apolinarykalemba/Pico-Cyberdeck/picture/IMG_20261005_202635_535.jpg

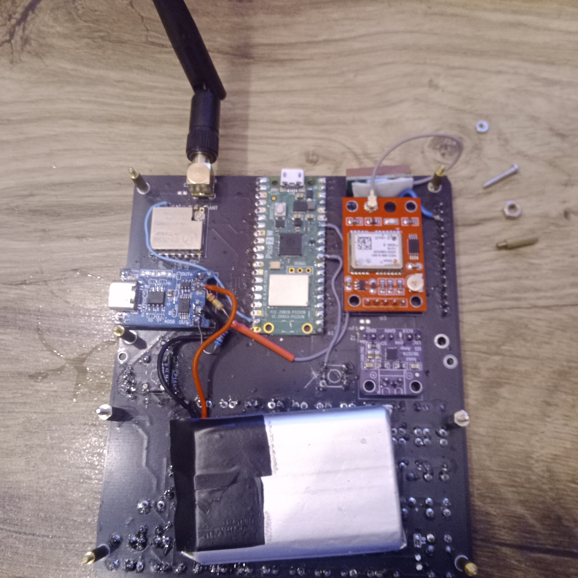
picture/IMG_20261005_202635_535.jpg
