apolinarykalemba/Pico-Cyberdeck/picture/IMG_20261005_202928_706.jpg

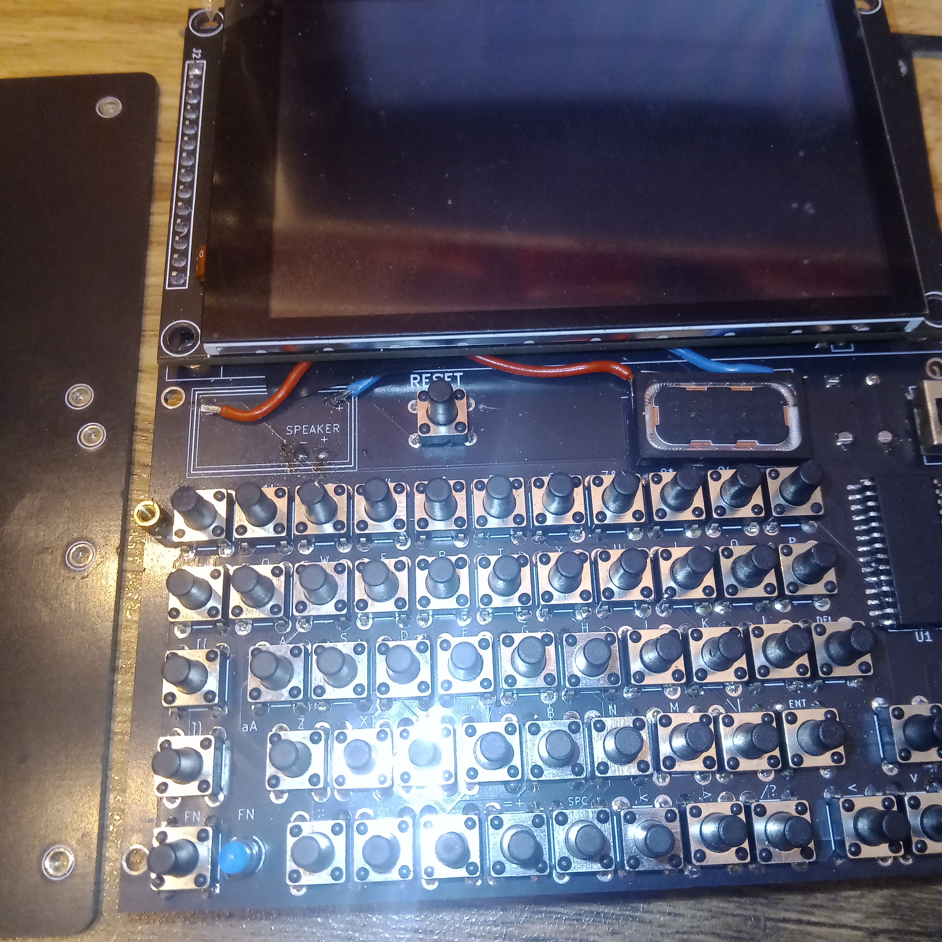
picture/IMG_20261005_202928_706.jpg
