apolinarykalemba/Pico-Cyberdeck/picture/IMG_20261005_202944_932.jpg

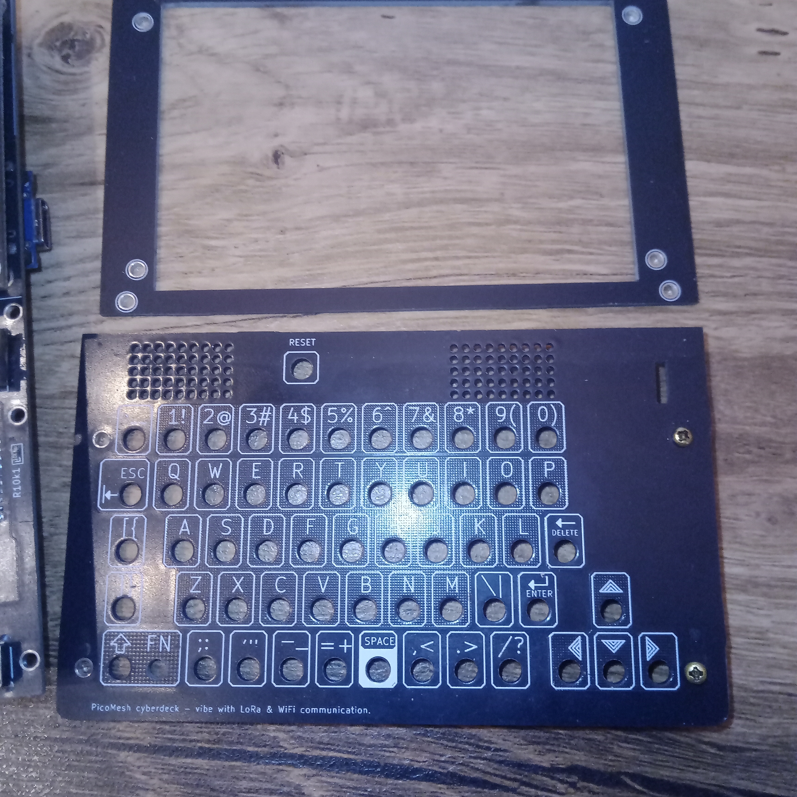
picture/IMG_20261005_202944_932.jpg
