apolinarykalemba/Pico-Cyberdeck/picture/IMG_20261005_202951_774.jpg

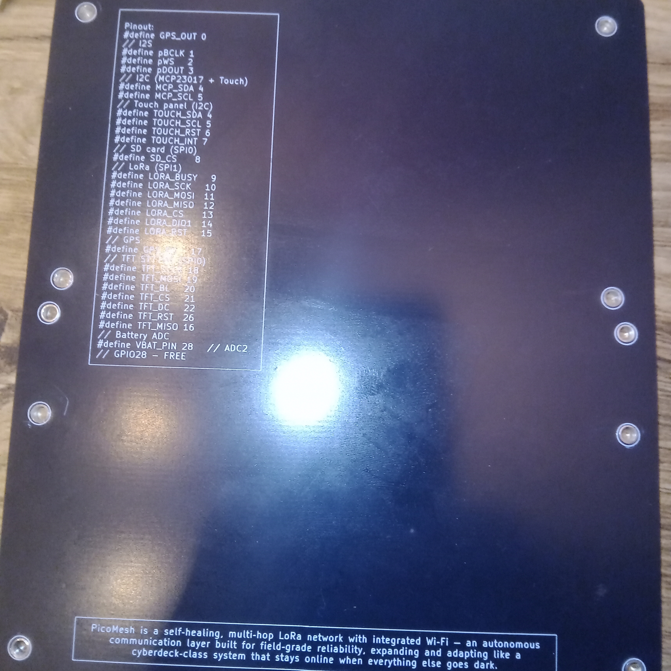
picture/IMG_20261005_202951_774.jpg
