apolinarykalemba/Pico-Cyberdeck/picture/Prototype_1.jpg

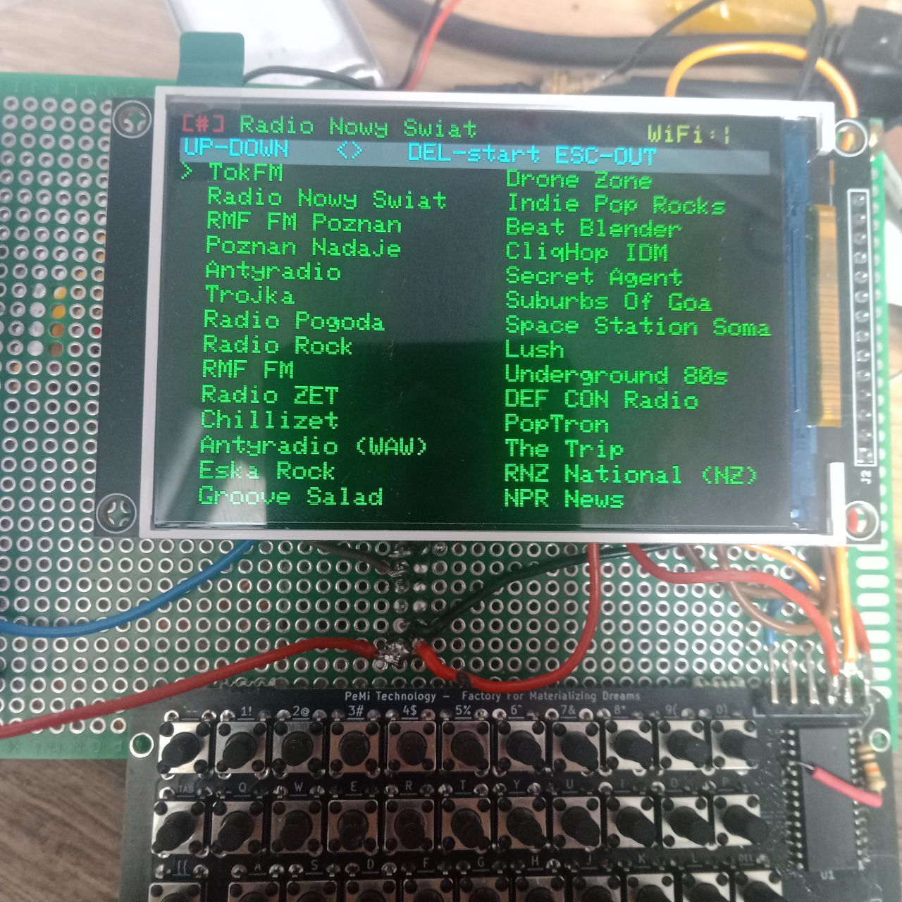
picture/Prototype_1.jpg
