apolinarykalemba/Pico-Cyberdeck/picture/Prototype_2.jpg

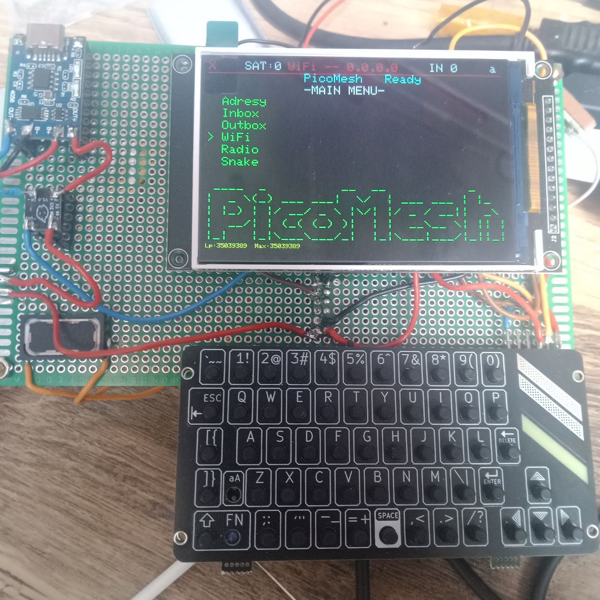
picture/Prototype_2.jpg
