apolinarykalemba/Pico-Cyberdeck/PicoDeck_Schemat.pdf

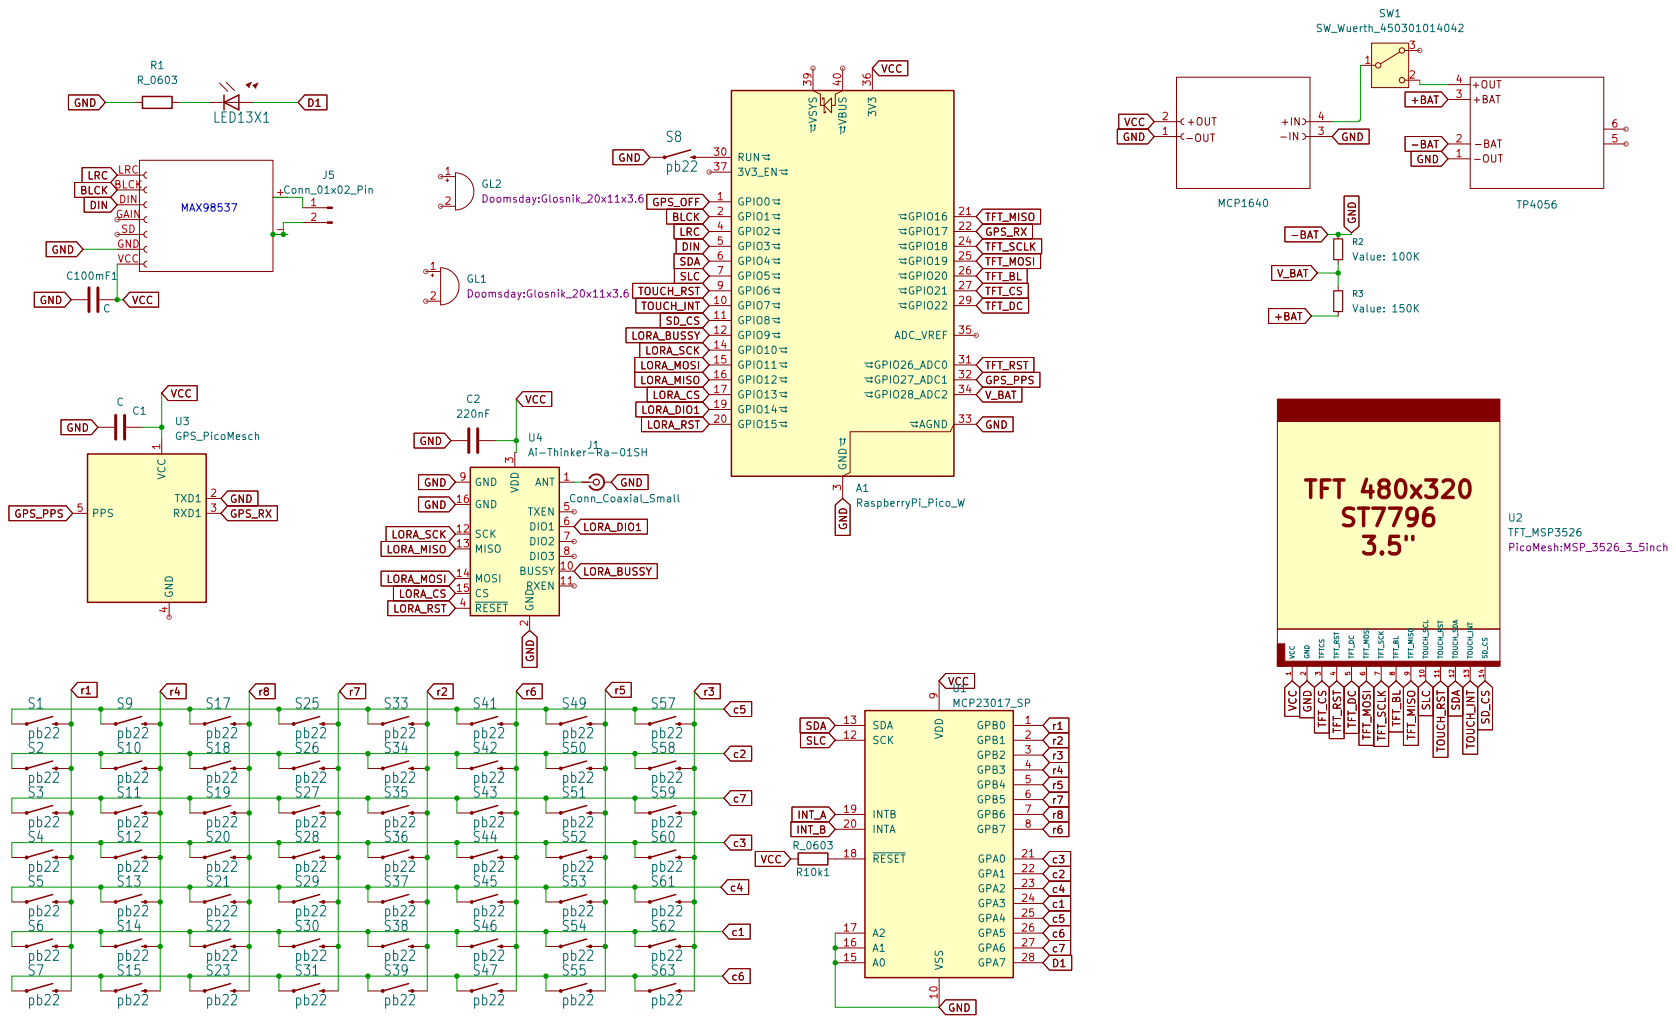
[picture p8: page 1]
