apolinarykalemba/Pico-Cyberdeck/PicoDeck.pdf

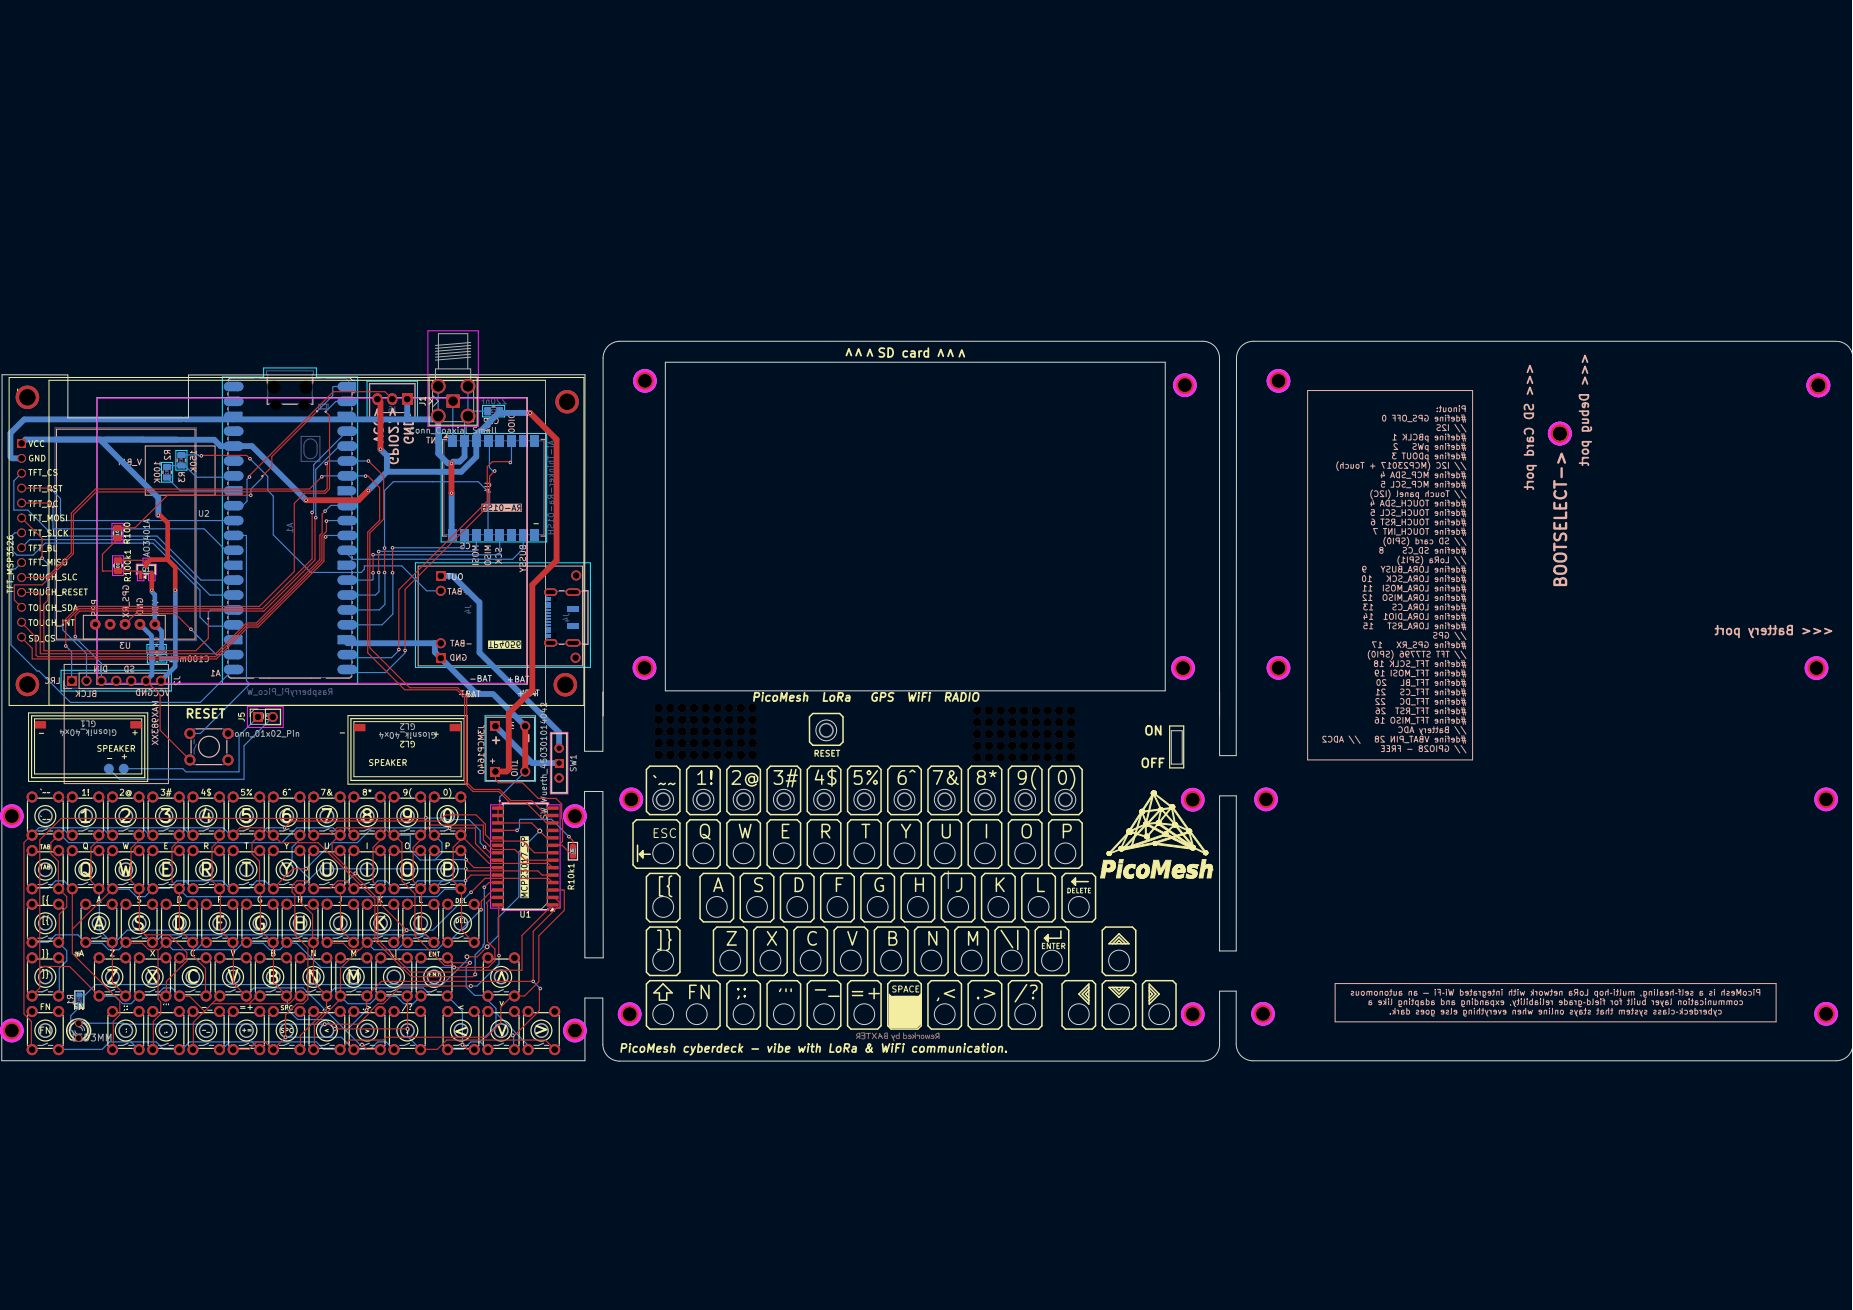
[picture p9: page 1]
